Joeymacmillan/Gamble-It-Project-Junior-Design-/(commit log)

2025-03-17 Update 3leds.ino
    Changed the time delay from 500ms to 1000ms after LED is set HIGH and then also added a 500ms delay after LED is set LOW.
2025-03-18 Add files via upload
    This is the code for the clapping roulette wheel
2025-03-18 Add files via upload
    This is an updated code for the roulette wheel with a speaker and it detecting if a clap was detected. If a clap is detected, a specific sound is made and if not, a specific sound is made to signal no clap and the game is over, the final score is displayed and you must clap to restart.
2025-03-21 Create slotscode.ino
    slots code
